mnsnoop/esp32Micronet/misc/IMG_20220224_231140370.jpg

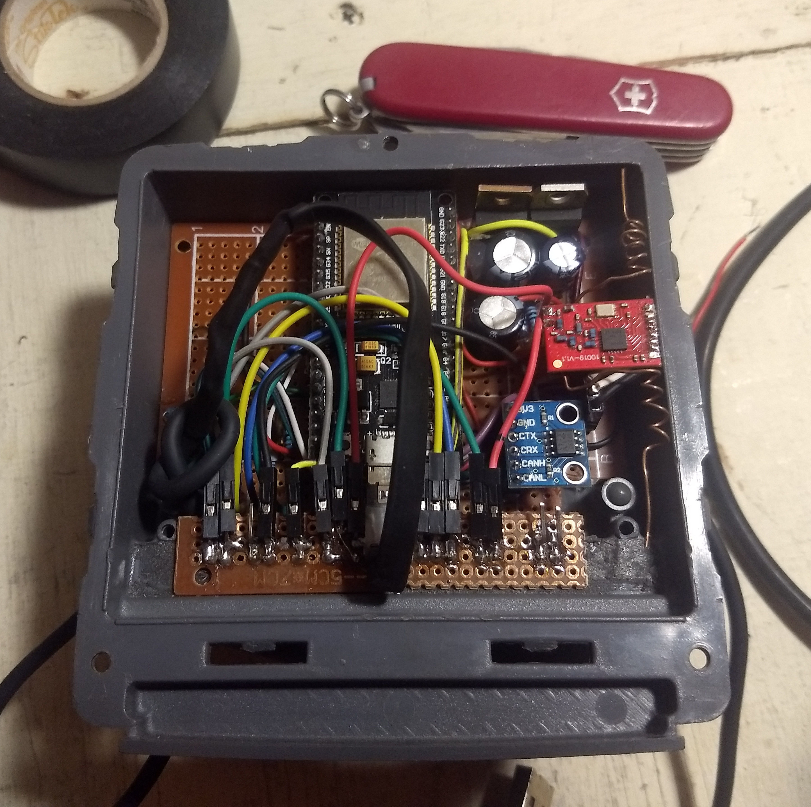
misc/IMG_20220224_231140370.jpg
