mnsnoop/esp32Micronet/misc/IMG_20220302_215451668.jpg

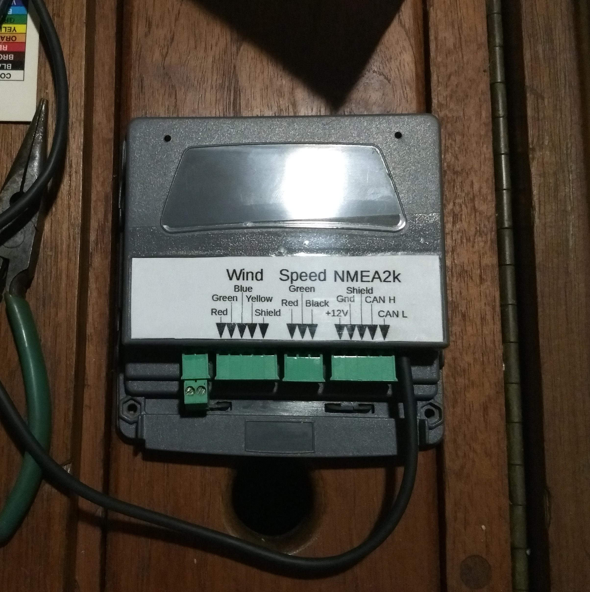
misc/IMG_20220302_215451668.jpg
