mnsnoop/esp32Micronet/backwards_engineering_data/test.txt

02.95397325 Prog Write 00100001:00011011 RX TX Freq: 0 - Modem1 Register LOCK_AVG_IN:1 LOCK_AVG_MODE:1 SETTLING 01 MODEM_RESET_N 1
