mnsnoop/esp32Micronet/(threads)

Thread 1 (2022-03-08):

Working well

pionex, 2022-03-08:
Apologies for creating an issue, but I did not see any other way to make contact.  This code is working great so far and only took me minutes to get my setup working.  I am able to send and receive data from my micronet network.  I saw a comment that you don't have anything that sends data, so let me know if I can provide some logs for you.  I am currently working on being able to set and toggle the race timer.

mnsnoop, 2022-03-08:
Good to hear. No worries on starting issues. I don't have anything micronet that generates data so the micronet to nmea bridge code is untested. I don't need data logs as much as people to test it. My messages was more a warning to those people that some of the conversions maybe off.

The race timer can be set multiple ways. My duel displays do it via 0xFD command packets. The project currently lacks the ability to send command packets because there was no need. The second way to set and start the timer is in the 0x02 data packet. You can send the same 0xFD command in a 0x02 packet. Here is the basic structure:

p->sHeader.bData[iLength + 0] = 0x06; //data length
p->sHeader.bData[iLength + 1] = 0xFD; //data id
p->sHeader.bData[iLength + 2] = 0x00; //unk
p->sHeader.bData[iLength + 3] = 0x05; //minutes
p->sHeader.bData[iLength + 4] = 0x00; //seconds
p->sHeader.bData[iLength + 5] = 0x00; //unk
p->sHeader.bData[iLength + 6] = 0x00; //0x00 = stop, 0x01 = run
p->sHeader.bData[iLength + 7] = GetCRC(p->sHeader.bData + iLength, 7); //0x64;

If you send this every second you'll have to update the values as the timer runs or else it'll reset the value.

Thread 2 (2022-03-08):

Handling Command / Parameter Packets

pionex, 2022-03-08:
I am trying to handle the command to set / reset the race timer.  Looking at another micronet project (https://github.com/Rodemfr/MicronetToNMEA/blob/master/Micronet.h) and my own received packets, I have determined that the 0xFD message that sets the timer is a 0x06 Command Packet rather than a 0x02 Data Packet.

I can now receive the messages from my racemaster, but I have not had luck yet sending a 0x06 message that will reset / start the timer.

The messages generated by the racemaster look like:
0130.731583:INF Got Timer Message0130.731638:DBG RX 022 bytes. +034181 μs: (p000000/d+34181)
| 81 09 18 C1 | 87 09 2A 56 | 06 | 19 00 92 | 14 14 | FD 00 09 00 01 00 48 4F

0xFD - Timer Setup
0x00 - Unknown (Seems to always be 0x00)
0x09 - Time in Minutes
0x00 - Unknown (seconds? although can't set seconds using UI)
0x01 - Unknown - Changes
0x00 - Unknown - Changes
0x48 - Counts up with each command
0x4F - Simple checksum of the previous 7 bytes

pionex, 2022-03-08:
Here are some more messages from the racemaster.  These are generated everytime I push the button with the circle to reset the timer back to the original value.  The 0x39 is the nearest minute (it was resetting it to 57).  I am still not sure why index 4 of the data payload changes between 02, 08, 10, 20, 40, and 80.  I also don't know how important the second to last byte is that increments with each press.

81 09 18 C1 | 87 09 2A 56 | 06 | 19 00 92 | 14 14 | FD 00 39 00 02 01 08 41
81 09 18 C1 | 87 09 2A 56 | 06 | 19 00 92 | 14 14 | FD 00 39 00 08 01 09 48
81 09 18 C1 | 87 09 2A 56 | 06 | 19 00 92 | 14 14 | FD 00 39 00 80 01 0A C1
81 09 18 C1 | 87 09 2A 56 | 06 | 19 00 92 | 14 14 | FD 00 39 00 80 01 0B C2
81 09 18 C1 | 87 09 2A 56 | 06 | 19 00 92 | 14 14 | FD 00 39 00 20 01 0C 63
81 09 18 C1 | 87 09 2A 56 | 06 | 19 00 92 | 14 14 | FD 00 39 00 40 01 0D 84
81 09 18 C1 | 87 09 2A 56 | 06 | 19 00 92 | 14 14 | FD 00 39 00 10 01 0E 55
81 09 18 C1 | 87 09 2A 56 | 06 | 19 00 92 | 14 14 | FD 00 39 00 80 01 0F C6
81 09 18 C1 | 87 09 2A 56 | 06 | 19 00 92 | 14 14 | FD 00 39 00 40 01 10 87

81 09 18 C1 | 87 09 2A 56 | 06 | 19 00 92 | 14 14 | FD 00 36 00 40 01 11 85

mnsnoop, 2022-03-08:
It's a good start. To handle command packets required a whole subsystem to keep track of all the network's settings, third round collision avoidance, command acknowledgement tracking, etc. If you're up for it god speed but if you want a quicker way using the data packet to control the timer as mentioned in issue 1 would be much easier.

There's little difference between data packets and command packets. I've sent data in command packets and commands in data packets. I believe the packets are misunderstood. 0x02 are like a UDP packet in that if they get dropped they get dropped while 0x06 are like a TCP packet being ack'd and counted.

Thread 4 (2022-05-16):

include files missing

dwarning, 2022-05-16:
I tried to setup the gnss (u-blox) and compass (lsm303dlhc) mod on top the main branch. But Arduino IDE could not compile because few include files are missing e.g. runningAngle.h RunningAverage.h etc.
So I must rm certain files which can included again if include files available.

mnsnoop, 2022-05-16:
I guess we could move the transducer code to another branch since most people won't be using it. I don't know how to do that, if you do let me know.

dwarning, 2022-05-16:
Oh, I overlooked this libraries. Now I restore the files and can compile all together but linking without the anemometer, n2kbridge and paddlewheel I got core panic and reboot. Must see!
Perhaps you like my approach with the defining in BoardConfig.h.

Thread 6 (2022-09-11):

bWorkingBytes get randomly overwritten

dgeppert, 2022-09-11:
problem:

- `rRadio->bWorkingBytes` is global class variable, may get overwritten

  - i.e. by `ISRDataIn` which fires at high frequency
    because CC1101 not configured to use SYNC_WORD, the esp32Micronet radio driver checks all for preamble and sync word etc.

- `Radio::OutgoingPacketHandler(void *r)` checks for radio state:

  - `if (rRadio->eRadioState != RS_IDLE) rRadio->Stop();` : we are in RS_IDLE BUT *should be* in RX_TX as we are in state `Listen()`

solution:

- `Radio::Listen()`

  `eInputState = IS_WAIT;`
  `eRadioState = RS_RX;` // <--- added this here and problem solved, first four bytes of `bWorkingBytes` no longer overwritten!!!

mnsnoop, 2022-09-11:
You are correct. This is a hack to decreases rx to tx switchover time for the CC1101.

When studying Micronet I captured the commands between the MCU and CC1000 in a hull transmitter and found the protocol demanded ~500us switch over time for the first device after the sync packet.

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
(Small excerpt from the datasheet: The microcontroller uses 3 output pins for the configuration interface (PDATA, PCLK and PALE). PDATA should be a bidirectional pin for data read-back. A bidirectional pin is used for data (DIO) to be transmitted and data received. DCLK providing the data timing should be connected to a microcontroller input. https://www.ti.com/lit/ds/symlink/cc1000.pdf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)

The CC1101 is slower then the CC1000 at this. If I tried fully idling the radio it'd miss the send window. Since Micronet needs very accurate timing I took that line out. The code still exists in the sender to honor the blocking and idle the radio before sending which is why adding it back worked.

It's a situational issue with no good solution. We either let the sender clobber receives when it needs or miss windows.

dgeppert, 2022-09-11:
thanks for these details, makes it understand better ;-)

some weeks ago I was trying to make esp32Micronet talk to MicronetToNMEA because I had no Micronet devices available.
it took me a weekend to figure out why bWorkingBytes was _clobber_, so the idea was to possibly point this out to others having the some problem.

this weekend I had the first occasion to test esp32Micronet with a real Micronet system, just works like a charm!

many thanks for sharing your work so others might profit and have some fun with it as well! ;-)
