mnsnoop/esp32Micronet/micronet.h

#ifndef _MICRONET_H
#define _MICRONET_H

#include "radio.h"

enum _eMNStatus //network states. main driver of wat do.
{
	MNS_NetworkChoice,			//Network Choice mode. How displays act. Listen to see if a network is running join if found or start one if not.
	MNS_Force_Node,				//Forced node mode. How hull transmitters act. Wake up to listen for a sync packet once a second. If none is detected go back to sleep. If we detect a network join the network.
	MNS_Force_Scheduler,		//Forced schedule mode. *fixme not implimented* scan for a network and if one is detected take over scheduler duties next 0x0a/0x0b exchange.
//above are the start values you can pick.
	MNS_NetworkChoice_S1,		//Listening for 1 second.
	MNS_NetworkChoice_S2,		//Listening for another second.
	MNS_NetworkChoice_M1,		//If no network is found announce ourselves as the scheduler to wake up other nodes and start sending sync packets.
	MNS_NetworkChoice_M2,		//Wait for our announcement to finish.
	MNS_NetworkChoice_N1,		//Network found. send out 0x03 packets till we get on the list. *fixme not implimented*
	MNS_Force_Node_Listening,	//Forced node mode listening for a network
	MNS_Connected,				//This is a marker to seperate unconnected and connected states for easy status checks. Not a valid state.
	MNS_NetworkChoice_Node,		//Network Choice node mode. *fixme not implimented*
	MNS_NetworkChoice_Scheduler,//Network Choice scheduler mode. *fixme not implimented*
	MNS_Force_Node_Connected,	//Forced node connected to a network. *fixme not implimented*
	MNS_Force_Scheduler_Connected //*fixme not implimented*
};

class _cMNId
{
	public:
	byte bId[4];

	bool operator ==(const _cMNId &id2)
	{
		if (bId[0] == id2.bId[0] && bId[1] == id2.bId[1] && bId[2] == id2.bId[2] && bId[3] == id2.bId[3])
			return true;
		else
			return false;
	}
	
	bool operator !=(const _cMNId &id2)
	{
		if (bId[0] != id2.bId[0] || bId[1] != id2.bId[1] || bId[2] != id2.bId[2] || bId[3] != id2.bId[3])
			return true;
		else
			return false;
	}
};

union _uMNPacket
{
	struct __attribute__((__packed__))
	{
		_cMNId mnIdNetwork;
		_cMNId mnIdDevice;
		byte bPacketType;
		byte bUnk1;
		byte bSignalQuality;
		byte bChecksum;
		byte bLength;
		byte bLengthChecksum;
		byte bData[MN_MAXPACKETSIZE - 14];
	} sHeader;
	byte bRaw[MN_MAXPACKETSIZE];
};

struct _sMNPSync
{
	_cMNId mnIdDevice;
	byte bWindowSize;
};

struct _sDataArrayIn //Micronet -> (...)
{
	uint16_t iSpeed;
	uint64_t tlSpeedUpdate = 0;
	
	int8_t iWaterTemp;
	uint64_t tlWaterTempUpdate = 0;
	
	uint16_t iDepth;
	uint64_t tlDepthUpdate = 0;
	
	uint16_t iAppWindSpeed;
	uint64_t tlAppWindSpeedUpdate = 0;
	
	int16_t iAppWindDir;
	uint64_t tlAppWindDirUpdate = 0;
	
	int16_t iHeading;
	uint64_t tlHeadingUpdate = 0;
		
	uint16_t iVolts;
	uint64_t tlVoltsUpdate = 0;
};

struct _sDataArrayOut //(...) -> Micronet
{
	uint16_t iSpeed;
	uint64_t tlSpeedUpdate = 0;
	
	uint32_t iTrip;
	uint32_t iLog;
	uint64_t tlTripLogUpdate = 0;
	
	int8_t iWaterTemp;
	uint64_t tlWaterTempUpdate = 0;
	
	uint16_t iDepth;
	uint64_t tlDepthUpdate = 0;
	
	uint16_t iAppWindSpeed;
	uint64_t tlAppWindSpeedUpdate = 0;
	
	int16_t iAppWindDir;
	uint64_t tlAppWindDirUpdate = 0;
	
	int16_t iHeading;
	uint64_t tlHeadingUpdate = 0;
	
	uint16_t iSOG; 
	uint16_t iCOG;
	uint64_t tlSOGCOGUpdate = 0;
	
	uint8_t iLatDegree;
	uint16_t iLatMinute;
	uint8_t iLongDegree;
	uint16_t iLongMinute;
	uint8_t iNESW;
	uint64_t tlLatLongUpdate = 0;
	
	uint16_t iBTW;
	char	cWPName[16];
	short	iWPNameScrollPos;
	uint64_t tlBTWUpdate = 0;

	int16_t iXTE;
	uint64_t tlXTEUpdate = 0;

	uint8_t iHour;
	uint8_t iMinute;
	uint64_t tlTimeUpdate = 0;
	
	uint8_t iDay;
	uint8_t iMonth;
	uint8_t iYear;
	uint64_t tlDateUpdate = 0;
	
	uint16_t iVMG_WP;
	uint64_t tlVMG_WPUpdate = 0;
	
	uint16_t iVolts;
	uint64_t tlVoltsUpdate = 0;
	
	uint32_t iDTW;
	uint64_t tlDTWUpdate = 0;

	uint8_t bNodeInfoType;
	uint8_t bNodeInfoVMajor;
	uint8_t bNodeInfoVMinor;
	bool bSendNodeInfo;
};

struct _sMNetHandler
{
	void (*cbCallback)(_sDataArrayIn sDataIn, void *v2);
	void *vArg;
};

class Micronet
{
	private:
	TaskHandle_t thMicronetWorker,
				 thIncomingPacketHandler;
				
	QueueHandle_t *qhIncomingPacket,
				  *qhOutgoingPacket;

	TimerHandle_t tiMicronet;

	_sMNetHandler sIncomingPacketHandlers[10];
	_sMNetHandler sTimerHandlers[10];

	_eMNStatus eMNStatus;
	
	uint64_t tLAnnounce;
	int iSyncPacketOffset; //offset from tickcount for when we expect sync packets (in us).

	_sMNPSync sMNSync[MN_MAXNODES];
	int iMNNodes;
	uint64_t tNextPing;
	uint64_t tCommandBlock;
	
	_sDataArrayIn sDataArrayIn;
	_sDataArrayOut sDataArrayOut;
	
	void IncomingPacketHandler(_sPacket *p); //handling of incoming packets.
	void MicronetWorker(); //runs during network deadtime.
	
	static void IncomingPacketHandlerCB(void *m);
	static void MicronetWorkerThread(void *m);
	static void SentPacketCallback(void *m, _sPacket *p, bool bSent);

	friend void MicronetTimerCallback(TimerHandle_t xTimer);

	int GetPacketWindow(_cMNId mnDevice, byte bPacketType, bool bFuture = false); //returns the window offset in us for the current or next round.
	uint64_t GetNextPacketWindow(_cMNId mnDevice, byte bPacketType) //returns the window offset in us for the next round.
	{
		return GetPacketWindow(mnDevice, bPacketType, true) + tLAnnounce;
	}

	int FindMNDeviceInSyncList(_cMNId mnDevice);
	
	void CreatePacket0x01(_uMNPacket *pPacket);
	void CreatePacket0x02(_uMNPacket *pPacket);
	void CreatePacket0x03(_uMNPacket *pPacket);
	void CreatePacket0x05(_uMNPacket *pPacket, int iNewWindowSize);
	void CreatePacket0x07(_uMNPacket *pPacket);
	void CreatePacket0x0B(_uMNPacket *pPacket);

	public:
	Radio CCRadio;
	
	Micronet();
	~Micronet();

	void Start();
	
	void AddTimerHandler(void (*cbCallback)(_sDataArrayIn sDataIn, void *v2), void *vArg); //access to timer. this fires every second during network dead time.
	void RemoveTimerHandler(void (*cbCallback)(_sDataArrayIn sDataIn, void *v2));

	//tSendTime is when the end of the syncword is sent, not the start of the preamble.
	void Send(_uMNPacket pPacket, uint64_t tSendTime, int iPreambleLength = MN_PREAMBLELEN);

	TaskHandle_t GetWorkerTaskHandle()
	{
		return thMicronetWorker;
	}

	TaskHandle_t GetIncomingPacketTaskHandle()
	{
		return thIncomingPacketHandler;
	}
	
	byte GetCRC(byte *b, int len);
	void PrintPacket(_sPacket *p, bool bSR, int iPrediction);
	void PrintPacket(_sPacket *p, bool bSR)
	{
		PrintPacket(p, bSR, 0);
	}

	void SetSpeed(float fSpeed);
	void SetTripLog(float fTrip, float fLog);
	void SetWaterTemperature(float fTemp);
	void SetDepth(float fDepth);
	void SetApparentWindSpeed(float fWindSpeed);
	void SetApparentWindDirection(float fWindDir);
	void SetHeading(float fHeading);
	void SetSOGCOG(float fSOG, float fCOG);
	void SetLatLong(float fLat, float fLong);
	void SetBTW(float fBTW);
	void SetWPName(char *cWPName);
	void SetXTE(float fXTE);
	void SetTime(uint8_t iHour, uint8_t iMinute);
	void SetDate(uint8_t iDay, uint8_t iMonth, uint8_t iYear);
	void SetVMG_WP(float fSpeed);
	void SetVolts(float fVolts);
	void SetDTW(float fDistance);
	
	//fixme: put these behind functions.
	_cMNId	mnIdMyNetwork,
		 	mnIdMyDevice;
	
	bool bPrintSends = true,
		 bPrintReceives = true;
};

extern Micronet mNet;

float readFloat(unsigned int addr);
void writeFloat(unsigned int addr, float x);

#endif // _MICRONET_H


/* 
 *  These notes are chaotic. 
 *  Some info maybe old or wrong.
 * 
 * Abandon all hope.

Nodes remember the sync list and on start will use thier memorized list instead of the one we send...

Basic time specs.
 13.02 us per bit
104.17 us per byte
  1771 us for 17 bytes (standard preamble)

Max packet size: 200
Max nodes: 32

NW = Network Id
DI = Device Id
UK = Unknown, believed to be a reciever mask or sender status bits.
NQ = Network quality (RSSI) for responce packets. 0-9 scale, 0 being didn't recieve the packet, 9 being strongest RSSI.
CS = Checksum. Previous bytes added togeather from the last checksum limited to one byte.
LN = Total packet length minus the LN fields.

0x01 Network synchronization packet. 
-First ring.
NW NW NW NW DI DI DI DI *01* UK NQ CS LN CS *81 00 01 00 00 00 00 12*

0x02 Data packet.
-Second ring.
NW NW NW NW DI DI DI DI *02* UK NQ CS LN CS *04 04 05 13 89 A9 04 1B 05 00 78 9C*

0x03 Add transmit slot packet.
-Third ring.
-Can and does collide with other third ring packets.
NW NW NW NW DI DI DI DI *03* UK NQ CS LN CS *00 1A 1A*

0x04 Remove transmit slot packet.
-Second ring.
NW NW NW NW DI DI DI DI *04* UK NQ CS LN CS 

0x05 Adjust transmit slot packet.
-Second ring.
NW NW NW NW DI DI DI DI *05* UK NQ CS LN CS *1A 1A*

0x06 Command packet.
-Third ring.
-Every node should reply with an 0x07. If not the node keeps sending the 0x06 for 5 times.
-Only one command packet can be handled at a second.
NW NW NW NW DI DI DI DI *06* UK NQ CS LN CS *E5 00 10 F5*

0x07 Announcement/Ack.
-Forth ring.
-Forth ring runs backwards.
NW NW NW NW DI DI DI DI *07* UK NQ CS LN CS 

0x08 Node leaving network.
-Second ring? (verify me pls)
NW NW NW NW DI DI DI DI *08* UK NQ CS LN CS 

0x09 Unknown, unseen, no reply.
NW NW NW NW DI DI DI DI *09* UK NQ CS LN CS 

0x0A Network status ping.
-Third ring, network controller only
-Used to cull dead nodes from sync list.
-Also checks to see if there is a device that wants to take over as scheduler.
NW NW NW NW DI DI DI DI *0A* UK NQ 7E LN CS 

0x0B Netowrk status pong. 3rd ring
-Forth ring.
-Forth ring runs backwards.
NW NW NW NW DI DI DI DI *0B* UK NQ 01 LN CS *00 00*

0x18 Passing scheduling duty to another device. The device's id reversed is the data.
NW NW NW NW DI DI DI DI *18* UK NQ CS LN CS *7C 62 03 81 62*

0x19 Acknolegement of passing scheduling duty by device taking over.
NW NW NW NW DI DI DI DI *19* UK NQ CS LN CS 


0x01 Network synchronization packet.
-First device in the list is always the scheduler and the it's window size is 3 + (5 * iMNNodes).
-The network sync packet has a hard limit of ~32ms length. 

0x02 Data packets.
-Types:
-0x01 - 06 byte Speed                0x04, 0x01, 0x05, 0x00, 0x64, 0x6E
-0x02 - 12 byte Trip/Log             0x0A, 0x02, 0x05, 0x00, 0x00, 0x00, 0x64, 0x00, 0x00, 0x00, 0x0A, 0x7F
-0x03 - 05 byte Temp                 0x03, 0x03, 0x05, 0x02, 0x0D
-0x04 - 06 byte Depth                0x04, 0x04, 0x05, 0x00, 0x0A, 0x17
-0x05 - 06 byte App Wind Speed       0x04, 0x05, 0x05, 0x00, 0x0A, 0x18
-0x06 - 06 byte App Wind Dir         0x04, 0x06, 0x05, 0x00, 0x01, 0x10
-0x07 - 06 byte HDG                  0x04, 0x07, 0x05, 0x00, 0x01, 0x11
-0x08 - 08 byte SOG/COG              0x06, 0x08, 0x05, 0x00, 0x0A, 0x00, 0x01, 0x1E
-0x09 - 11 byte LAT/LONG             0x09, 0x09, 0x05, 0x01, 0x03, 0xE8, 0x01, 0x03, 0xE8, 0x00, 0xEF
-0x0A - 12 byte BTW                  0x0A, 0x0A, 0x05, 0x01, 0x01, 0x01, 0x01, 0x01, 0x01, 0x01, 0x01, 0x21
-0x0B - 06 byte XTE                  0x04, 0x0B, 0x05, 0x00, 0x64, 0x78
-0x0C - 06 byte Time                 0x04, 0x0C, 0x05, 0x01, 0x00, 0x16
-0x0D - 07 byte Date                 0x05, 0x0D, 0x05, 0x01, 0x01, 0x01, 0x1A
- ...
-0x10 - 08 byte Node Info            0x06, 0x10  0x01, 0x02, 0x20, 0x23, 0x08, 0x64
- ...
-0x12 - 06 byte VMG-WP               0x04, 0x12, 0x05, 0x00, 0x64, 0x7F 
- ...
-0x1B - 06 byte Battery              0x04, 0x1B, 0x05, 0x00, 0x0A, 0x2E
- ...
-0x1F - 08 byte DTW                  0x06, 0x1F, 0x05, 0x00, 0x00, 0x00, 0x01, 0x2B
- ...
-0xFD - 08 byte timer stop/start/set	0x06, 0xFD, 0x00, 0x01, 0x00, 0x00, 0x00, 0x04

-TWDIR needs App Wind Speed, App Wind Dir, HDG
-BEAUF needs App Wind Speed, App Wind Dir, HDG
-MAG TWDIR needs App Wind Speed, App Wind Dir, HDG
-HEAD/LIFT needs App Wind Speed, App Wind Dir, HDG (this one takes a little bit to fill in as its a running average)
-VMG needs App Wind Speed, App Wind Dir, Speed
-TRUE WIND SPEED needs App Wind Speed, App Wind Dir, Speed
-TRUE WIND DIR needs App Wind Speed, App Wind Dir, Speed
-ETA/TTG needs VMG-WP and DTW.

0x03 Add transmit slot packet.
-Data is an unknown 0x00 byte followed by the window size you want then a checksum. Repeating this packet with a different window size does not change your window size.
-First byte might be an 0x0A byte to signal wanting sync duty. Need to check.

0x04 Remove transmit slot packet.
-Send this will remove your node's id from the sync list.

0x05 Adjust transmit slot packet.
-Data is one byte which is the new window size and a checksum.

0x06 Command packets.

0xE5 0x00 Display backlight command.
Backlight Off: 01 0A 8B 60 81 03 61 7C 06 09 00 66 10 10 E5 00 10 F5 
Backlight  L1: 01 0A 8B 60 81 03 61 7C 06 09 00 66 10 10 E5 01 0D F3 
Backlight  L2: 01 0A 8B 60 81 03 61 7C 06 09 00 66 10 10 E5 02 0E F5 
Backlight  L3: 01 0A 8B 60 81 03 61 7C 06 09 00 66 10 10 E5 03 0F F7 

0xFF Settings command.
FF 01 01 00 24 25
CW RG SS SS CT CS
CW = Command word.
RG = Registry.
SS = Settings.
CT = Counter. Every time a setting is changed this increments. Probably for synchronization. Doesn't seem to matter as I've sent out 00 multiple times and the display took the setting.
CS = Checksum.

0xFF Reg 0x00 Speed adj. +/- 200%
    speed +1%: 01 0A 8B 60 81 03 61 7C 06 09 00 66 12 12 FF 00 01 33 6D A0 
	speed +2%: 01 0A 8B 60 81 03 61 7C 06 09 00 66 12 12 FF 00 01 34 6E A2 
  speed +200%: 01 0A 8B 60 81 03 61 7C 06 09 00 66 12 12 FF 00 01 FA 6F 69 

0xFF Reg 0x01 General Settings.
Default settings (all zeros) are: Depth feet, Speed knots, Wind knots, Log units nm. Is bit based. Not fully mapped.
      Default: 01 0A 8B 60 81 03 61 7C 06 09 00 66 12 12 FF 01 01 00 24 25 0000 0001 0000 00001 0000 0000
  Speed   mph: 01 0A 8B 60 81 03 61 7C 06 09 00 66 12 12 FF 01 01 01 30 32 0000 0001 0000 00001 0000 0001
  Speed  kmph: 01 0A 8B 60 81 03 61 7C 06 09 00 66 12 12 FF 01 01 02 2F 32 0000 0001 0000 00001 0000 0010
 Log units sm: 01 0A 8B 60 81 03 61 7C 06 09 00 66 12 12 FF 01 01 04 26 2B 0000 0001 0000 00001 0000 0100
 Log units  m: 01 0A 8B 60 81 03 61 7C 06 09 00 66 12 12 FF 01 01 08 25 2E 0000 0001 0000 00001 0000 1000 
Depth  meters: 01 0A 8B 60 81 03 61 7C 06 09 00 66 12 12 FF 01 01 10 13 24 0000 0001 0000 00001 0001 0000
Depth fathoms: 01 0A 8B 60 81 03 61 7C 06 09 00 66 12 12 FF 01 01 20 15 36 0000 0001 0000 00001 0010 0000
  Wind meters: 01 0A 8B 60 81 03 61 7C 06 09 00 66 12 12 FF 01 01 40 1F 60 0000 0001 0000 00001 0100 0000

0xFF Reg 0x02 Sea temp adj. +/- 10c
     temp .5c: 01 0A 8B 60 81 03 61 7C 06 09 00 66 12 12 FF 02 01 01 6B 70
     temp +1c: 01 0A 8B 60 81 03 61 7C 06 09 00 66 12 12 FF 02 01 02 6C 70 
	temp +10c: 01 0A 8B 60 81 03 61 7C 06 09 00 66 12 12 FF 02 01 14 6E 84 

0xFF Reg 0x0B More General Settings/Some alarm settings. Bit based. Not fully mapped.
       Temp f: 01 0A 8B 60 81 03 61 7C 06 09 00 66 12 12 FF 0B 01 01 2D 39 0000 1011 0000 00001 0000 0001 (default is c)
 WP Arv Alarm: 01 0A 8B 60 81 03 61 7C 06 09 00 66 12 12 FF 0B 01 10 5B 76 0000 1011 0000 00001 0001 0000
    Alarm XTE: 01 0A 8B 60 81 03 61 7C 06 09 00 66 12 12 FF 0B 01 20 67 92 0000 1011 0000 00001 0010 0000
Spd frmt 0.01: 01 0A 8B 60 81 03 61 7C 06 09 00 66 12 12 FF 0B 01 40 38 83 0000 1011 0000 00001 0100 0000 (default is 0.1)

0xFF Reg 0x11 Depth alarm deep.
    depth alarm deep 1ft: 01 0A 8B 60 81 03 61 7C 06 09 00 66 12 12 FF 11 01 01 57 69 
    depth alarm deep 2ft: 01 0A 8B 60 81 03 61 7C 06 09 00 66 12 12 FF 11 01 02 5A 6D 

0xFF Reg 0x12 Depth alarm shallow.
Depth alarm shallow .5ft: 01 0A 8B 60 81 03 61 7C 06 09 00 66 12 12 FF 12 01 05 54 6B 
Depth alarm shallow  1ft: 01 0A 8B 60 81 03 61 7C 06 09 00 66 12 12 FF 12 01 0A 59 75 

0xFF Reg 0x13 CRSE Alarm.
CRSE Alarm 1 degree : 01 0A 8B 60 81 03 61 7C 06 09 00 66 13 13 FF 13 02 01 00 5D 72
CRSE Alarm 2 degrees: 01 0A 8B 60 81 03 61 7C 06 09 00 66 13 13 FF 13 02 02 00 5E 74 


0x07 Announcement/Ack

All commands should get a 07 reply from all nodes


0x08 Node leaving network

During pairing when a node is leaving a network for a new one it sends 0x08 packets to the old network.


0x09 Unknown unseen no reply


0x0A Network status ping.

Part of device culling and master switching. The scheduler will send these out until it gets a responce from all devices in the list.


0x0B Network status pong.

Rsponce is the level of importance of a device. If a device with a higher number then the one running the network replies then sync duties gets passed on to it.
00 - how a hull transmitter responses
10 - how a slave display reponds
90 - how a master display responds


0x18 Passing scheduling duty to another device. 

The device's id reversed is the data. Device needs to respond with a 0x19 packet.


0x19 Acknolegement of passing scheduling duty by device taking over.

The current scheduler will send out 4 more sync packets before the switchover happens.



Notes:

Pairing

Status bit change, 5+ second preamble, 60 seconds join peroid with special status bit (0f wait 0d join). Devices joining the new network that are running an old network send out 0x08 packets. After 60 seconds nodes update thier NID to the new network.
Device Id's are not static. If a device comes online to find it's id in use it'll increment its id and request a new window. 


Scheduling
first slot always the node running the network. Not seen it used. Might just be a spacer.

Micronet devices lock avgfilter after ~20 bits of preamble.


Full pairing
21:43:22.312 -> 0125.00720000: Received 042 bytes. 00000μs:| 01 01 01 02 | 81 03 61 91 | 01 | 09 00 85 | 28 28 | 81 03 61 91 1C 00 00 00 02 01 00 00 00 03 01 00 00 00 04 01 00 00 00 05 01 00 00 A4 
21:43:23.306 -> 0126.00720004: Received 042 bytes. 00000μs:| 01 01 01 02 | 81 03 61 91 | 01 | 09 00 85 | 28 28 | 81 03 61 91 1C 00 00 00 02 01 00 00 00 03 01 00 00 00 04 01 00 00 00 05 01 00 00 A4 
21:43:24.300 -> 0127.00720002: Received 042 bytes. 00000μs:| 01 01 01 02 | 81 03 61 91 | 01 | 09 00 85 | 28 28 | 81 03 61 91 1C 00 00 00 02 01 00 00 00 03 01 00 00 00 04 01 00 00 00 05 01 00 00 A4 
21:43:25.327 -> 0128.00720003: Received 042 bytes. 00000μs:| 01 01 01 02 | 81 03 61 91 | 01 | 09 00 85 | 28 28 | 81 03 61 91 1C 00 00 00 02 01 00 00 00 03 01 00 00 00 04 01 00 00 00 05 01 00 00 A4 
21:43:26.321 -> 0129.00720002: Received 042 bytes. 00000μs:| 01 01 01 02 | 81 03 61 91 | 01 | 09 00 85 | 28 28 | 81 03 61 91 1C 00 00 00 02 01 00 00 00 03 01 00 00 00 04 01 00 00 00 05 01 00 00 A4 
21:43:27.315 -> 0130.00720001: Received 042 bytes. 00000μs:| 01 01 01 02 | 81 03 61 91 | 01 | 0F 00 8B | 28 28 | 81 03 61 91 1C 00 00 00 02 01 00 00 00 03 01 00 00 00 04 01 00 00 00 05 01 00 00 A4 
21:43:28.309 -> 0131.00720002: Received 042 bytes. 00000μs:| 01 01 01 02 | 81 03 61 91 | 01 | 0F 00 8B | 28 28 | 81 03 61 91 1C 00 00 00 02 01 00 00 00 03 01 00 00 00 04 01 00 00 00 05 01 00 00 A4 
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
0573.525575: Received 018 bytes. +023100 μs:| 01 01 01 01 | 81 03 61 91 | 06 | 09 07 90 | 10 10 | E5 00 07 EC 
0573.531579: Received 014 bytes. +030047 μs:| 01 01 01 01 | 01 0B 8B 61 | 07 | 01 08 0C | 0C 0C | 
0573.537575: Received 014 bytes. +035523 μs:| 01 01 01 01 | 81 03 62 7C | 07 | 09 09 7F | 0C 0C | 
0573.542575: Received 014 bytes. +040925 μs:| 01 01 01 01 | 81 03 61 91 | 07 | 09 07 91 | 0C 0C | 
0574.504052:     Sent 037 bytes. +000000 μs:| 01 01 01 01 | 01 01 01 01 | 01 | 09 00 12 | 23 23 | 01 01 01 01 17 81 03 61 91 00 81 03 62 7C 00 01 0B 8B 61 1A 00 00 05 
0574.510898: Received 026 bytes. +008138 μs:| 01 01 01 01 | 01 0B 8B 61 | 02 | 01 00 FF | 18 18 | 04 04 06 13 89 AA 04 1B 05 00 00 24 
0574.532576: Received 016 bytes. +030355 μs:| 01 01 01 01 | 01 0B 8B 61 | 0B | 01 00 08 | 0E 0E | 00 00 
0574.537577: Received 016 bytes. +035575 μs:| 01 01 01 01 | 81 03 62 7C | 0B | 09 00 7A | 0E 0E | 90 90 
0574.542897: Received 016 bytes. +040975 μs:| 01 01 01 01 | 81 03 61 91 | 0B | 09 00 8E | 0E 0E | 10 10 
*/
