mnsnoop/esp32Micronet/adc_cal.h

const int ADC_LUT[4096] = { 0,
35,41,47,49,50,51,52,53,55,56,57,58,59,60,61,
63,64,65,66,67,68,69,70,71,72,73,74,75,76,77,
78,79,80,81,82,83,84,85,86,87,88,89,90,92,93,
94,95,96,97,98,99,100,101,102,104,105,106,107,108,109,
111,112,113,114,115,116,117,118,119,121,122,123,124,125,126,
127,128,130,131,132,134,135,136,137,139,140,141,143,144,145,
146,147,148,149,149,150,151,152,153,154,155,156,157,158,159,
160,161,163,164,165,167,168,169,171,172,174,175,176,177,178,
179,180,181,182,183,184,185,186,187,188,189,190,191,192,193,
194,195,197,198,199,200,202,203,204,205,207,208,209,210,211,
212,213,213,214,215,216,217,218,219,220,221,222,223,224,225,
226,227,228,229,230,231,233,234,235,236,237,238,239,240,242,
243,244,245,247,248,249,250,252,253,254,255,256,258,259,260,
261,262,263,264,265,266,267,268,270,271,272,273,274,275,276,
277,278,279,280,281,282,283,284,285,286,287,288,289,290,291,
292,293,294,295,296,298,299,300,301,302,303,304,305,306,307,
308,309,310,312,313,314,315,316,317,318,319,320,321,322,323,
324,325,326,327,328,329,330,331,332,334,335,336,337,338,339,
341,342,343,344,345,347,348,349,350,352,353,354,355,355,356,
357,358,359,360,361,362,363,364,365,366,367,368,369,370,372,
373,374,375,376,378,379,380,381,383,384,385,387,388,389,390,
392,393,394,396,397,398,400,401,402,403,404,405,405,406,407,
408,409,410,411,412,413,414,415,416,417,418,419,420,421,422,
423,424,425,426,427,428,429,430,431,432,433,434,435,436,437,
439,440,441,442,443,444,446,447,448,449,450,451,452,453,454,
455,456,457,458,459,460,461,462,464,465,466,467,468,469,470,
471,472,473,474,475,476,477,478,479,480,481,483,484,485,486,
487,488,489,490,491,492,494,495,496,497,498,499,500,501,502,
503,504,505,506,507,508,509,510,511,512,513,514,516,517,518,
519,520,521,523,524,525,526,527,528,529,530,531,532,533,534,
535,535,536,537,538,539,540,541,542,543,544,545,546,547,549,
550,551,553,554,555,556,558,559,560,561,562,563,564,566,567,
568,569,570,571,572,573,574,575,576,577,578,579,580,582,583,
584,585,586,587,588,589,590,591,592,593,594,594,595,596,596,
597,598,598,599,600,601,601,602,603,603,604,605,605,606,607,
607,608,610,611,612,614,615,616,618,619,620,622,623,624,625,
626,627,629,630,631,632,633,634,635,637,638,639,640,641,642,
643,645,646,647,648,649,651,652,653,654,655,656,658,659,660,
661,662,663,664,665,666,668,669,670,671,672,673,674,675,676,
677,679,680,681,682,683,684,685,686,687,688,689,690,691,692,
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
};
