mnsnoop/esp32Micronet/(commit log)

2022-03-04 init upload
    [digitaltest.csv, micronet 0x03 timing.ods, possible alarm.csv]
2022-05-16 -added a 10 minute auto restart function to head off any issues from long uptimes. -pinned tasks to specific cores to keep transducers from interfering with micronet radio communication. -recoded the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
    [anemometer.cpp, anemometer.h, esp32Micronet.ino, micronet.cpp, micronet.h, paddlewheel.cpp, paddlewheel.h, printbuffer.cpp]
2022-05-16 removed referances to testmodes that no longer exist
    [micronet.cpp, micronet.h]
2022-06-01 Fix bug found by dwarning in issue #5 regarding increasing our window size while being the scheduler.
    [micronet.cpp]
2022-06-01 Fixed bug found by dwarning in issue #5 regarding changing our window size as scheduler. We'll try to send data in the first slot which might not be valid. The first slot is normally used as a guard 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
    [micronet.cpp]
